wuxx/icesugar-nano/doc/icesugar-nano-bottom.png

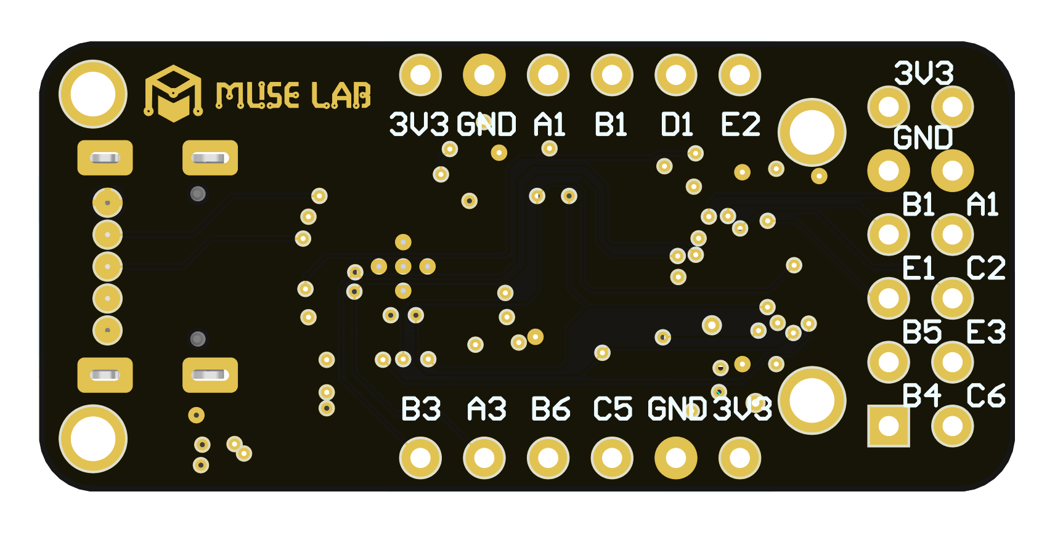
doc/icesugar-nano-bottom.png
