wuxx/icesugar-nano/doc/icesugar-nano-top.png

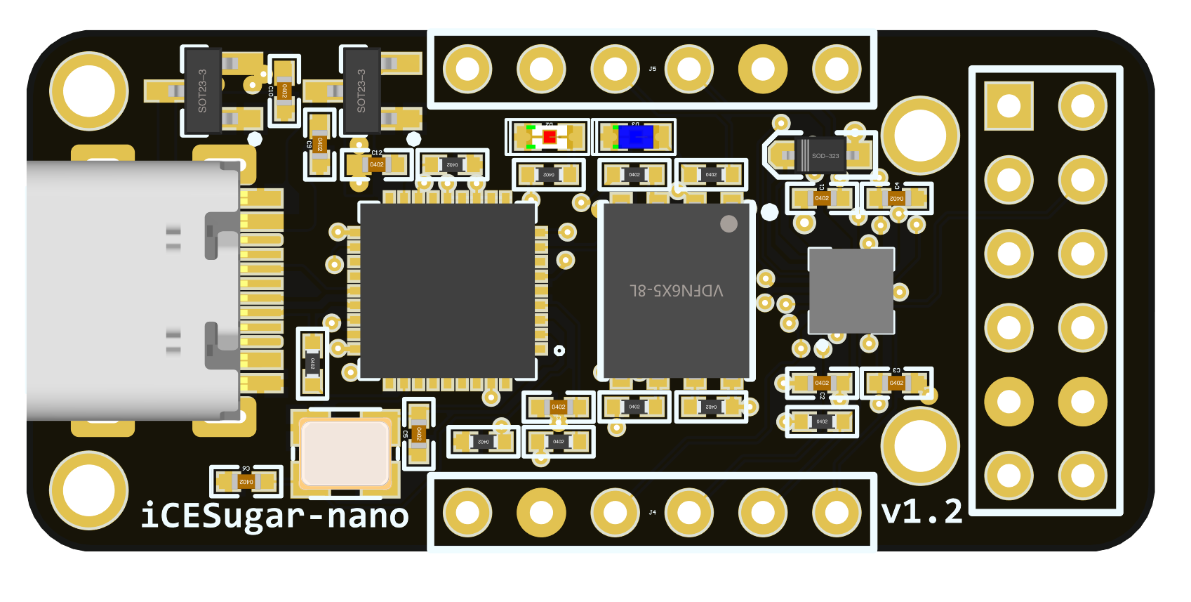
doc/icesugar-nano-top.png
