wuxx/icesugar-nano/doc/icesugar_nano_2.jpg

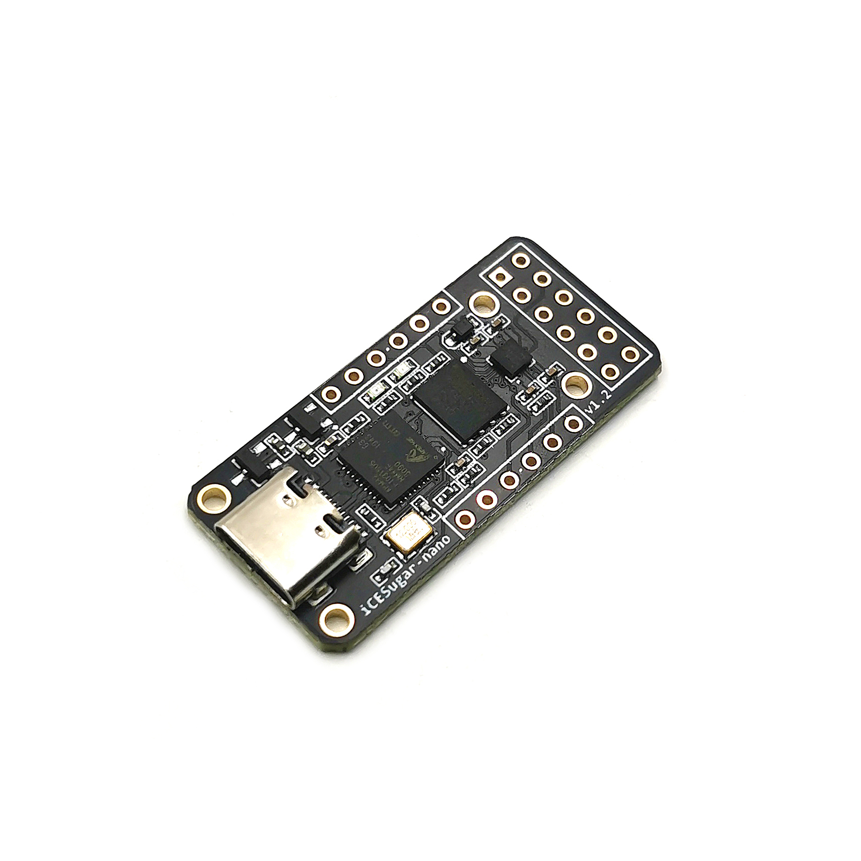
doc/icesugar_nano_2.jpg
