wuxx/icesugar-nano/doc/icesugar_nano_3.jpg

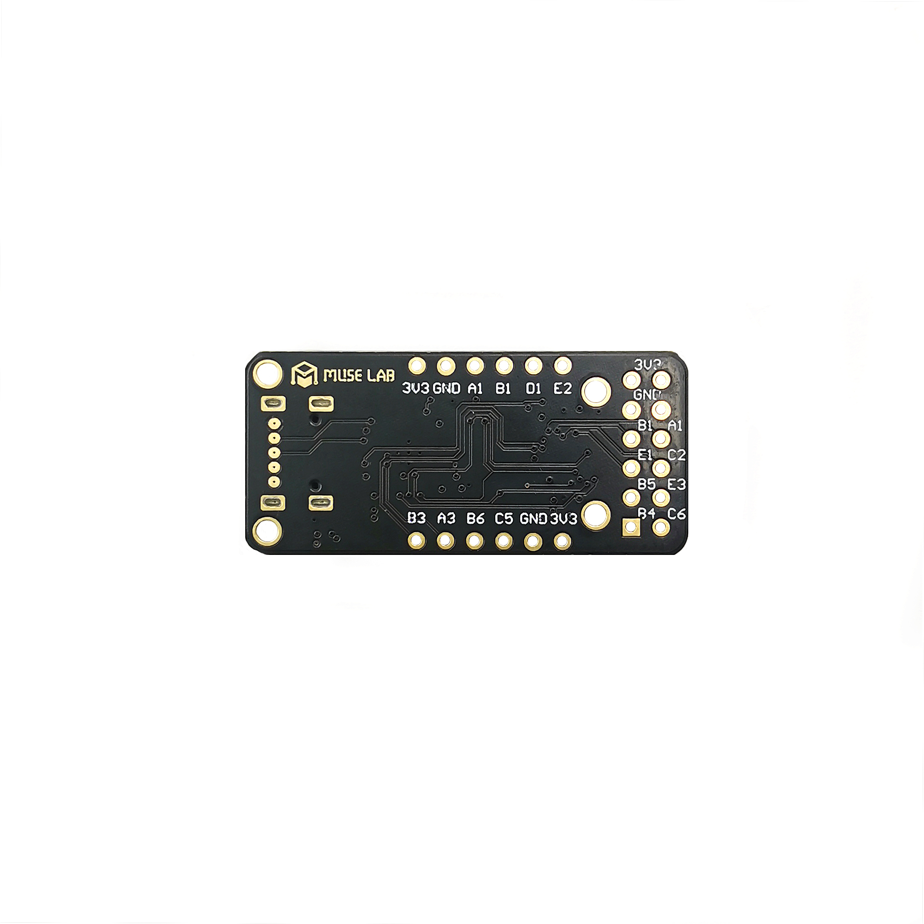
doc/icesugar_nano_3.jpg
