wuxx/icesugar-nano/doc/icesugar_nano_4.jpg

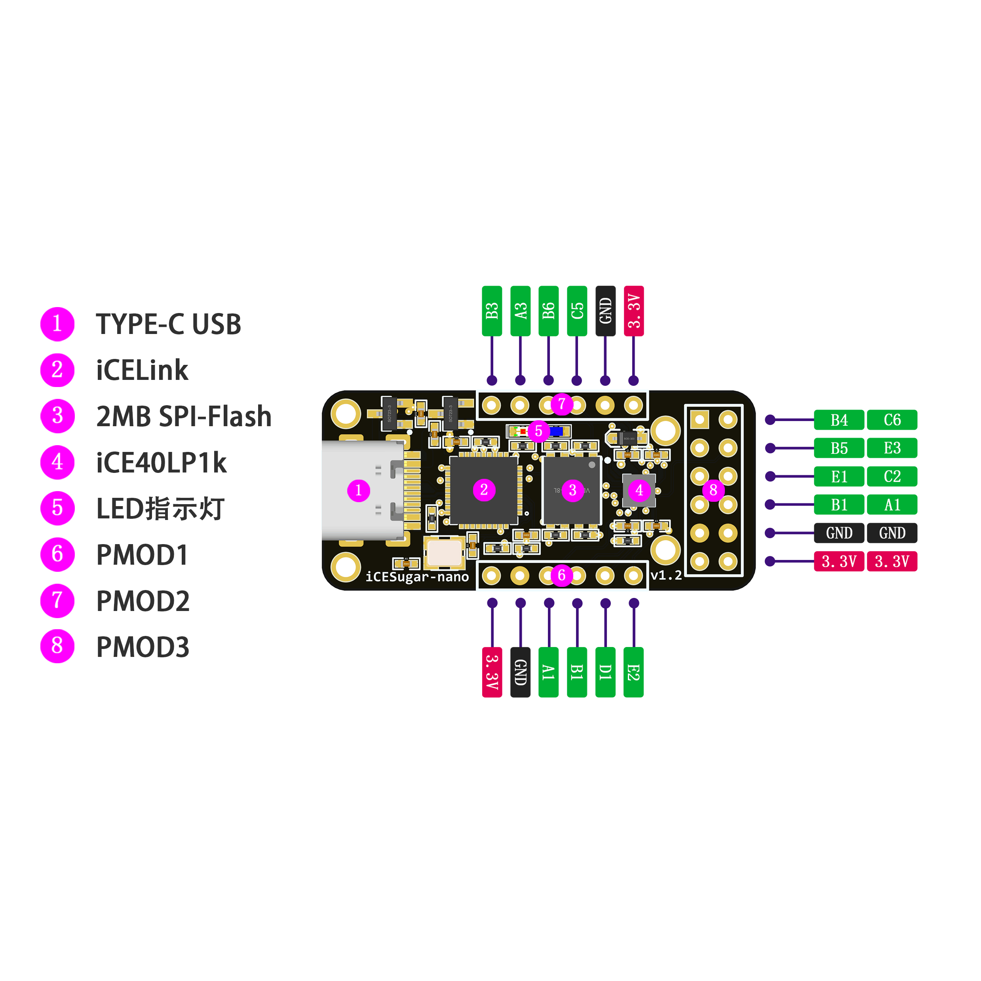
doc/icesugar_nano_4.jpg
