wuxx/icesugar-nano/doc/icesugar_nano_5.jpg

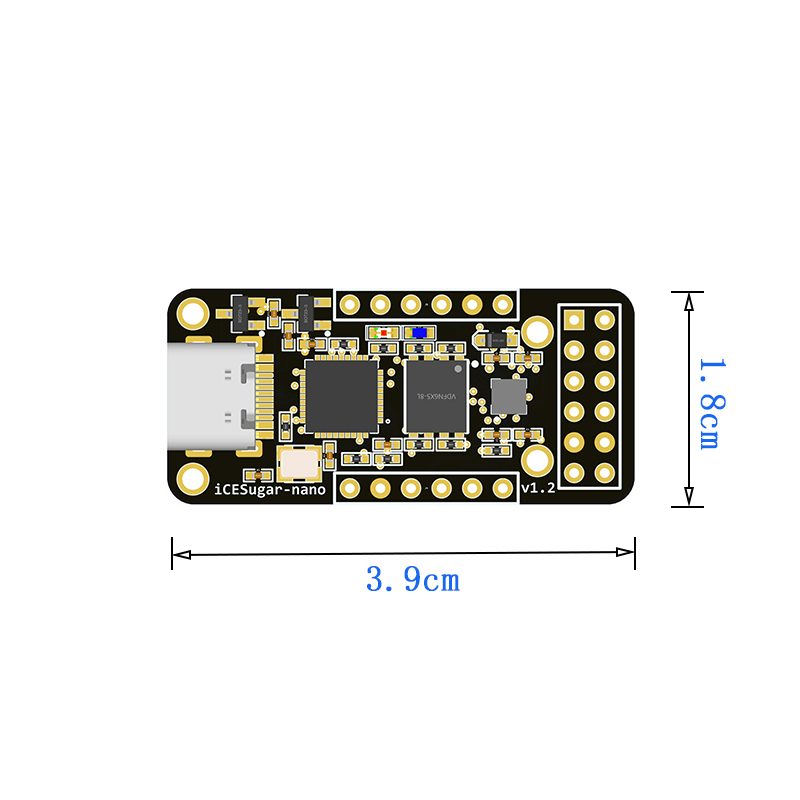
doc/icesugar_nano_5.jpg
