wuxx/icesugar-nano/schematic/ICESugar-nano-v1.2.pdf

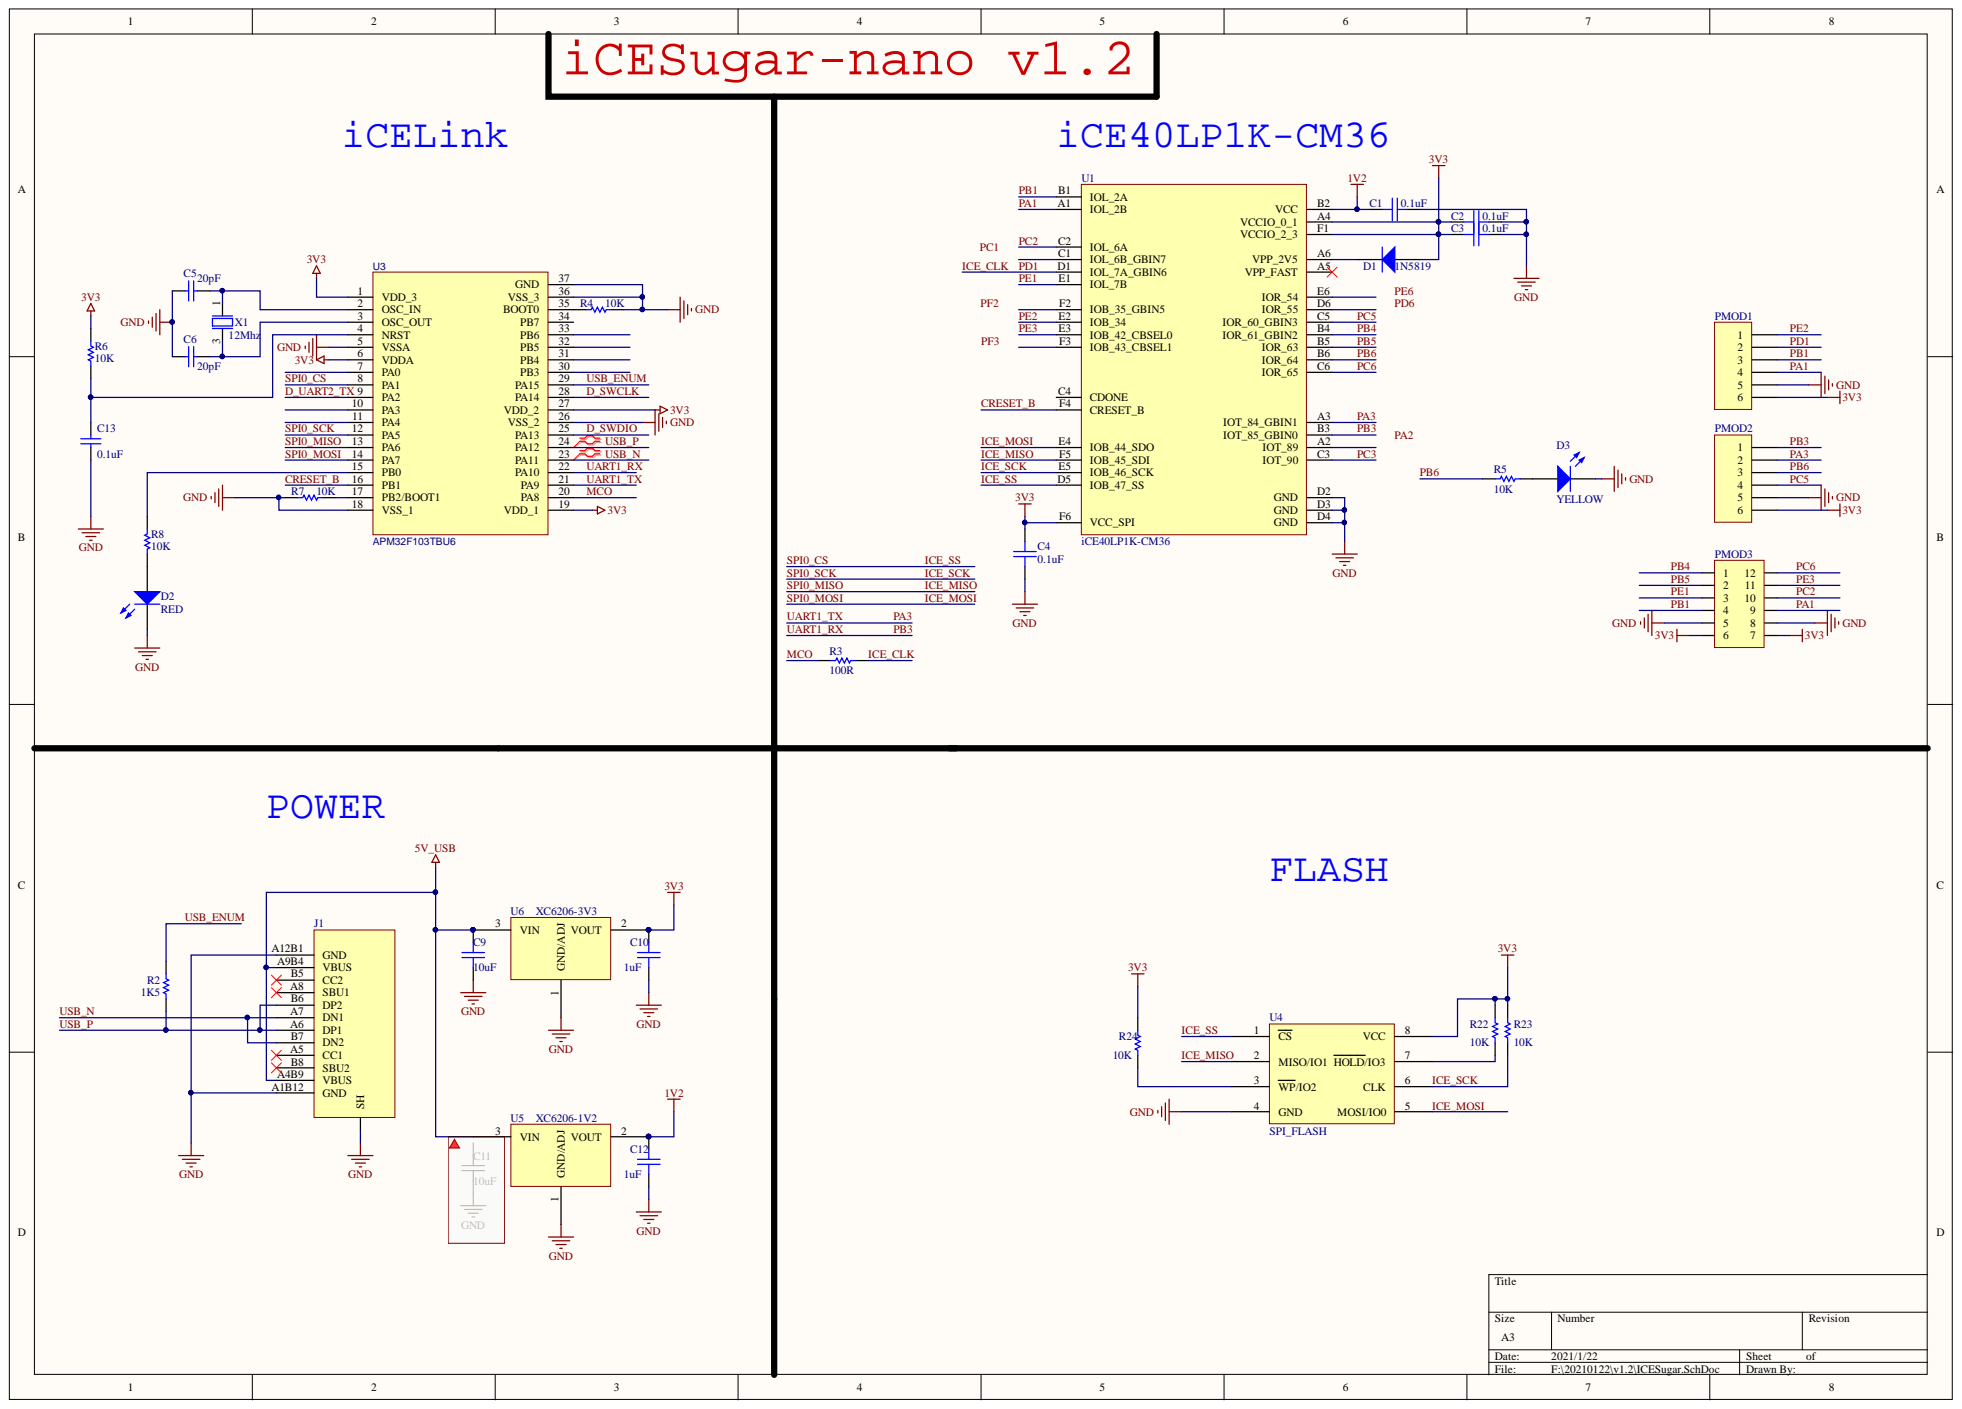
[picture p8: page 1]
