wuxx/icesugar-nano/(threads)

Thread 1 (2021-08-06):

Add resistors to usb cc pins

david-sawatzke, 2021-08-06:
The board currently doesn't work when connected to a usb-c port, because the resistors on cc1/cc2 are missing. To fix this resistors need to be added, similar to the ones on nanoDLA (https://raw.githubusercontent.com/wuxx/nanoDLA/master/hardware/v1.3/nanoDLA.pdf).

wuxx, 2021-08-07:
yes, next version will fix this problem, thanks

abderraouf-adjal, 2021-12-09:
@wuxx Hi, is this issue fixed in v1.3?
Also, may you upload v1.3 sch and and its related PCB files?

VIPQualityPost, 2023-06-21:
I don't think this was fixed.. my board (v1.2 shipped 6/23) does not have these resistors either.

stavinsky, 2023-08-05:
same for me. works only via adapter or with usb A cable
spend about an hour until found this issue. Thanks. Mine is also 1.2.

babtechs, 2023-09-09:
The same problem for me, Hope a new version will come out soon.

fred-corp, 2025-06-21:
Same here... v1.2 in 2025, no 5.1k resistors..

Thread 4 (2021-11-20):

Set permanent clock speed.

TiNredmc, 2021-11-20:
Hello, I've been thinking if the on-board APM32 can save last state of clock speed, by utilizing SPI Flash to store the MCO frequency that can later read back. Here's procedure.

0. Power on.
1. Keep FPGA under reset by pull CRESET_B low, SPI flash now free to use.
2. Check the last address of Flash whether we already store the Freq configuration (prevent override and First boot friendly after production).
2.1 If There's the configuration, just read and set the MCO output according to that data.
2.2 If not, Write the default 12MHz. to that region.
3. If user want to change the frequency of the MCO via the command line, put FPGA under reset and write to the last address of Flash to store new frequency and also output that frequency to MCO too.
4. Release the CRESET_B pin.

P.S.
Since the FPGA is working at Fixed Frequency. Reset the FPGA would necessary to reprogram the binary which already changed the timing in the code to match new frequency. So I don't think procedure number 3 is a problem.
Also the reason to use the very last address on the Flash is because I want to stay away from the FPGA Binary.

wuxx, 2021-11-21:
hello, will consider it, thanks~!

TiNredmc, 2021-11-21:
Oh, BTW. The 2MB Flash got plenty of space, that FPGA only require ~32KiB.

Closed 2021-11-23.

Thread 5 (2021-12-14):

opensource iCELink.

TiNredmc, 2021-12-14:
Hi, Did you have any plan to opensource the iCELink of iCESugar nano? Maybe I can use my free time to implement the MCO frequency retention feature to the iCELink.

abderraouf-adjal, 2021-12-25:
Yes, we need the debugger/programmer firmware source-code to modify the frequencies and fix bugs if the board become unsupported by the developer.

TiNredmc, 2021-12-26:
> Yes, we need the debugger/programmer firmware source-code to modify the frequencies and fix bugs if the board become unsupported by the developer.

Actually, I'm currently working on opensource firmware with Drag and drop feature. Really complex FatFS, MSD usb and more. Gonna take a while butbI can't really risk flashing it on the APM32 since I don't have the original formware of that

abderraouf-adjal, 2022-04-06:
@wuxx

Hello, after commit [cb6ebf2](https://github.com/wuxx/icesugar-nano/commit/cb6ebf2a894d2e2a3e5e5cc81e42aea160ac69f5) will I assume that the source code of the flashing firmware will be available soon with instructions on how to compile and flash the uploader?

Please note that this is very important for us so we can change the default settings.

TiNredmc, 2022-05-01:
Hi @abderraouf-adjal I already made the open source version of the iCELink firmware available. Note that There's only Drag N Drop programming feature available, No UART<->iCE40 (Only for iCELink Debug) and MCO frequency fixed at 48MHz (Clock source for iCE40LP1K). [https://github.com/TiNredmc/OpeniCELink](OpeniCELink)

abderraouf-adjal, 2022-05-01:
That great!

I hope you don't mind this non-related request: Please test this PR for running RISC-V programs from SPI flash in icesugar-nano!
The owner of that repo might accept it if others confirm.

[learn-fpga/pull/66](https://github.com/BrunoLevy/learn-fpga/pull/66)

TiNredmc, 2022-05-01:
@abderraouf-adjal Have some bad news. I did flashed the code to the APM32 (STM32 Clone used in this board). But It's not working and I can't get the debugger to work (there're many workaround and I tried, non of them work). I want you to stay away from that code until I get it work. Plus, Don't even try to dump the original code. It's read protected....

Thread 6 (2022-05-01):

Can't find iCE FTDI USB device

pythops, 2022-05-01:
I got this error when I try to flash `blink.bin` into the board.

```
$ iceprog blink.bin
init..
Can't find iCE FTDI USB device (vendor_id 0x0403, device_id 0x6010 or 0x6014).
ABORT.
```
I tried `iceprog` with sudo and I got the same result
I have all the tools mentioned here https://clifford.at/icestorm installed.

Os: Arch Linux

Do you have any idea on how to solve it ?

Thanks

abderraouf-adjal, 2022-05-01:
The right tool is `icesprog`, not `iceprog`.

pythops, 2022-05-01:
Thanks very much :))

brandcrz88, 2024-05-02:
Hi, I hope someone you finds this useful.

I am using Ubuntu, for me the problem had to do with setting the rules and permissions properly.

- Stablish your PATH on your predetermined Shell:

export PATH="/path/to/fomu-toolchain-Linux/bin:$PATH"

- You can see that running "make prog" trows that err, this fixes that:

sudo /path/to/fomu-toolchain-Linux/bin/iceprog stopwatch.bin

- Now make that permanent. Check your device ID with:

lsusb

- If necessary, change your device rules, I had to change my idProduct from 6011 to 6010, and then add a GROUP="dialout".

- Go to:

sudo /etc/udev/rules.d/99-usb-serial.rules

- I changed:

SUBSYSTEM=="usb", ATTRS{idVendor}=="0403", ATTRS{idProduct}=="6011", MODE="0666"

- To:

SUBSYSTEM=="usb", ATTRS{idVendor}=="0403", ATTRS{idProduct}=="6010", MODE="0666", GROUP="dialout"

- Reload the rules with:

sudo udevadm control --reload-rules

sudo udevadm trigger

- Add user:

sudo usermod -aG dialout $USER

I hope that now you can run make prog directly from /stopwatch-dual

yweihong, 2024-06-10:
Oh I found out that I don't actually need to create the `50-myusb.rules`.

I can just add the user to `plugdev` group and I can program the iCEStick without sudo.

As `/lib/udev/rules.d/40-fpga-icestorm.rules` already specified it.

Closed 2022-05-01.

Thread 8 (2023-09-03):

Link to vm mega is dead

jbittoum, 2023-09-03:
the link to the mega.nz VM is dead

abderraouf-adjal, 2023-09-03:
Hello,
Try using this tool-chain: [YosysHQ/oss-cad-suite-build](https://github.com/YosysHQ/oss-cad-suite-build/releases)

Thread 11 (2024-02-09):

uart echo example not working?

haaslukas, 2024-02-09:
I'd like to add a uart feature to my project and first wanted to test the uart echo code from the demo repo [here](https://github.com/wuxx/icesugar-nano/blob/main/src/basic/uart_echo/)
I flashed the [.bin ](https://github.com/wuxx/icesugar-nano/blob/main/src/basic/uart_echo/pll_uart_mirror.bin) file to the icesugar-nano and connected via the CoolTerm terminal application (baudrate 115200, 8 data bits, no parity, 1 stop bit). when sending data I see the led flickering on the icesugar-nano. so something seems to arrive. but I'm not getting any readable symbols back despite seeing some Rx coming in on the CoolTerm.
I also build the project myself with apio and doing the direct loopback `assign TX = RX;`, but even then I don't see any "useful" data coming back.
I also tried different terminal applications like putty or a screen command on linux. the same problem everywhere. any idea how to continue or fix the code? did anyone got the uart echo example to work?

haaslukas, 2024-02-09:
ok, never mind. just found the bug. need to activate line mode in the terminal in order to see the data coming back on the RX line. and I'm also able to build with `apio`, but needed to change the code slightly:
```
`include "uart_rx.v"
`include "uart_tx.v"

module top (
	input CLK,
	input RX,
  output TX,
	output reg LED
);

wire clk_42mhz;

/* local parameters */
localparam clk_freq = 12_000_000; // 12MHz
//localparam clk_freq = 42_000_000; // 42MHz
//localparam baud = 57600;
localparam baud = 115200;

/* instantiate the rx1 module */
wire rx1_ready;
wire [7:0] rx1_data;
uart_rx #(clk_freq, baud) urx1 (
	.clk(CLK),
	.rx(RX),
	.rx_ready(rx1_ready),
	.rx_data(rx1_data)
);

/* instantiate the tx1 module */
reg tx1_start;
reg [7:0] tx1_data;
wire tx1_busy;
uart_tx #(clk_freq, baud) utx1 (
	.clk(CLK),
	.tx_start(tx1_start),
	.tx_data(tx1_data),
	.tx(TX),
	.tx_busy(tx1_busy)
);

// Send the received data immediately back

reg [7:0] data_buf;
reg data_flag = 0;
reg data_check_busy = 0;
always @(posedge CLK) begin

  // we got a new data strobe
  // let's save it and set a flag
	if(rx1_ready && ~data_flag) begin
    data_buf <= rx1_data;
    data_flag <= 1;
    data_check_busy <= 1;
  end

  // new data flag is set let's try to send it
  if(data_flag) begin

    // First check if the previous transmission is over
    if(data_check_busy) begin
      if(~tx1_busy) begin
        data_check_busy <= 0;
      end // if(~tx1_busy)

    end else begin // try to send waiting for busy to go high to make sure
      if(~tx1_busy) begin
        tx1_data <= data_buf;
        tx1_start <= 1'b1;
        //LED_R <= ~data_buf[0];
        //LED_G <= ~data_buf[1];
        LED <= ~data_buf[1];
      end else begin // Yey we did it!
        tx1_start <= 1'b0;
        data_flag <= 0;
      end
    end
  end
end

// Loopback the TX and RX lines with no processing
// Useful as a sanity check ;-)
//assign TX = RX;

endmodule
```

haaslukas, 2024-02-09:
ok, never mind. just found the bug. need to activate line mode in the terminal in order to see the data coming back on the RX line. and I'm also able to build with `apio`, but needed to change the code slightly:
```
`include "uart_rx.v"
`include "uart_tx.v"

module top (
	input CLK,
	input RX,
  output TX,
	output reg LED
);

wire clk_42mhz;

/* local parameters */
localparam clk_freq = 12_000_000; // 12MHz
//localparam clk_freq = 42_000_000; // 42MHz
//localparam baud = 57600;
localparam baud = 115200;

/* instantiate the rx1 module */
wire rx1_ready;
wire [7:0] rx1_data;
uart_rx #(clk_freq, baud) urx1 (
	.clk(CLK),
	.rx(RX),
	.rx_ready(rx1_ready),
	.rx_data(rx1_data)
);

/* instantiate the tx1 module */
reg tx1_start;
reg [7:0] tx1_data;
wire tx1_busy;
uart_tx #(clk_freq, baud) utx1 (
	.clk(CLK),
	.tx_start(tx1_start),
	.tx_data(tx1_data),
	.tx(TX),
	.tx_busy(tx1_busy)
);

// Send the received data immediately back

reg [7:0] data_buf;
reg data_flag = 0;
reg data_check_busy = 0;
always @(posedge CLK) begin

  // we got a new data strobe
  // let's save it and set a flag
	if(rx1_ready && ~data_flag) begin
    data_buf <= rx1_data;
    data_flag <= 1;
    data_check_busy <= 1;
  end

  // new data flag is set let's try to send it
  if(data_flag) begin

    // First check if the previous transmission is over
    if(data_check_busy) begin
      if(~tx1_busy) begin
        data_check_busy <= 0;
      end // if(~tx1_busy)

    end else begin // try to send waiting for busy to go high to make sure
      if(~tx1_busy) begin
        tx1_data <= data_buf;
        tx1_start <= 1'b1;
        //LED_R <= ~data_buf[0];
        //LED_G <= ~data_buf[1];
        LED <= ~data_buf[1];
      end else begin // Yey we did it!
        tx1_start <= 1'b0;
        data_flag <= 0;
      end
    end
  end
end

// Loopback the TX and RX lines with no processing
// Useful as a sanity check ;-)
//assign TX = RX;

endmodule
```

Closed 2024-02-09.

Thread 13 (2024-02-19):

Flash APM32F103

yathAg, 2024-02-19:
Hi @wuxx ,

I wanted to understand the FLASH process for the APM32F103. I have a custom project based on the schematics of the icesugar-Nano ( Thank you for making it open-source!).

 I tried flashing the [flash_imge.bin](https://github.com/wuxx/icesugar-nano/blob/main/firmware/flash_image.bin) using the STlink utility. It was successfully flashed at the starting address `0x08000000`. But Iceprog fails to detect the board.

I did set the Udev Rules, and this is the command I'm using to flash
```
iceprog blink.bin
```
This is the output for the same
```
init..
Can't find iCE FTDI USB device (vendor_id 0x0403, device_id 0x6010 or 0x6014).
ABORT.
```

Is the process I'm following for flashing the APM32F103 Correct? If not could you please correct me or point out any other issues that could be causing the same?

Thanks a lot for the help!

wuxx, 2024-02-20:
hello, please try icesprog, not iceprog, here is the source code and executable
https://github.com/wuxx/icesugar/tree/master/tools

yathAg, 2024-02-20:
Also on entering `lsusb` i see no specific USB device connected

```
Bus 002 Device 001: ID 1d6b:0003 Linux Foundation 3.0 root hub
Bus 001 Device 004: ID 0bda:1100 Realtek Semiconductor Corp.
Bus 001 Device 005: ID 413c:2113 Dell Computer Corp.
Bus 001 Device 008: ID 0bda:1100 Realtek Semiconductor Corp.
Bus 001 Device 009: ID 046d:08e5 Logitech, Inc.
Bus 001 Device 007: ID 413c:a510 Dell Computer Corp.
Bus 001 Device 006: ID 0bda:5409 Realtek Semiconductor Corp.
Bus 001 Device 003: ID 0bda:5409 Realtek Semiconductor Corp. USB2.1 Hub
Bus 001 Device 002: ID 413c:301a Dell Computer Corp. Dell MS116 USB Optical Mouse
Bus 001 Device 001: ID 1d6b:0002 Linux Foundation 2.0 root hub
```

yathAg, 2024-02-20:
I also tried using `sudo` and the rules mentioned here [https://github.com/wuxx/icesugar/tree/master/tools/src#install-60-icesugarrules](https://github.com/wuxx/icesugar/tree/master/tools/src#install-60-icesugarrules)

wuxx, 2024-02-21:
Hello, has the flash image programming been successful? You can check your hardware soldering to see if it is successful.

yathAg, 2024-02-22:
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

It does flash succesfully

yathAg, 2024-03-02:
Hi @wuxx , I got an Icesugar-nano from a friend, and the toolchain seems to work perfectly. And I was able to run some examples, too!!

I soldered cables to the bottom side of the board and connected them to the ST-link cube programmer. On reflashing the icesugar-nano with [flash_image.bin](https://github.com/wuxx/icesugar-nano/blob/main/firmware/flash_image.bin). The board no longer works.

So I'm definitely doing something wrong with how I am flashing the firmware image. Could you please help me with the same??

This is the output of the Cube programmer

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

Thanks for all the help.

wuxx, 2024-03-04:
Hello, please try programming the firmware here.
https://github.com/wuxx/icesugar/tree/master/firmware

yathAg, 2024-03-06:
Hi, thank you for the info, however this fails too :(

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

I can successfully flash the image, yet after connecting the icesugar nano to the desktop, it is not detected

Thread 16 (2025-04-06):

Having trouble getting icesprog to recognize IceSugar-Nano

FPGA-Joe568, 2025-04-06:
I have been struggling to get the Lattice IceSugar-Nano to get recognized by the icesprog program and I have tried several things.

I have tried following the installation instructions on both Ubuntu 22.04 LTS and Ubuntu 20.04 LTS.
I have also looked into the FTDI rules at /etc/udev/rules.d/80-fpga-ftdi.rules file and see:
 ATTRS{idVendor}=="1d50", ATTRS{idProduct}=="602b", MODE=="0660", GROUP=="plugdev", TAG+="uaccess"

I am using VirtualBox VM and enabling USB devices, so lsusb does provide:
 Bus 002 Device 003: ID 1d50:602b OpenMoko, Inc. FPGALink

Here is what I am getting for icesprog -p:
 probe chip
 flash id: 0xef4016
 unknown (??MB)
 done

Are there any special Linux commands I might need to run to fix this?

Thank you

wuxx, 2025-04-07:
hello, please try the latest icesprog here
https://github.com/wuxx/icesugar/tree/master/tools

FPGA-Joe568, 2025-04-07:
I tried the one under tools/ and the one under src/ but I'm still getting the same problem:

tools/./icesprog -p
probe chip
flash id: 0xef4016
unknown (??MB)
done

src/./icesprog -p
probe chip
board: [IceSugar-Nano]
flash: unknown flash id 0xef4016 (??MB)
done

I recently tried adding the FTDI D2XX driver, but with or without it doesn't fix the problem.
I also tried adding the libftdi1 library to the Makefile for the src/ one, still didn't fix it.

Closed 2025-04-19.

Thread 17 (2025-04-23):

how can i connect stlink to the apm32

quantrpeter, 2025-04-23:
hi
   how can i connect stlink to the apm32? since no jtag pin is on the pin header.
thanks
Peter

quantrpeter, 2025-04-23:
Is it opensource?

wuxx, 2025-04-23:
Sorry, the firmware is currently not open source

Thread 18 (2025-07-18):

Programming ICEsugar nano under Windows10

juergenuk, 2025-07-18:
I have just received the ICEsugar nano boardboard.
Red LED comes on for a short time.
Yellow LED on D6 is blinking.
But I cannot find the steps to set up ICEsugar nano under Windows10.
I want to stay away from the free tools, as I am using ICEcube2 with ICEstick and Nandland Go Board now already
to take the .BIN files generated under the ICEcube2 software and paste into the relevant ICEprog folder.
Have I missed the relevant link in your documentation?
Thank you very much for your help.

juergenuk, 2025-07-21:
It seems the problem was the USB cable.
I changed it and suddenly I can see the drive.
I hope it all works now.
I am just programming my first .bin file now.
The yellow LED is on,
The red LED flashing.
Sorry for the confusion.
Sa the drive did not appear, I assumed it has to be installed.
My mistake.
Sorry
