wuxx/icesugar-nano/(commit log)

2021-01-22 update schematic & doc & src
2021-08-22 Fix led example
    non-existent pcf file and led was off with given verilog
    [led.v]
2021-08-22 Fix uart example
